eagletrt/an2can/README.md

# Analog to CAN converter

Standalone system capable of performing analog-to-digital conversion and preprocessing and output data over CAN BUS

## Contributors
Latest to oldest:
- Thomas Nonis
