eagletrt/an2can/an2can.kicad_pcb

## KiCad design an2can.kicad_pcb (2023-05-17)

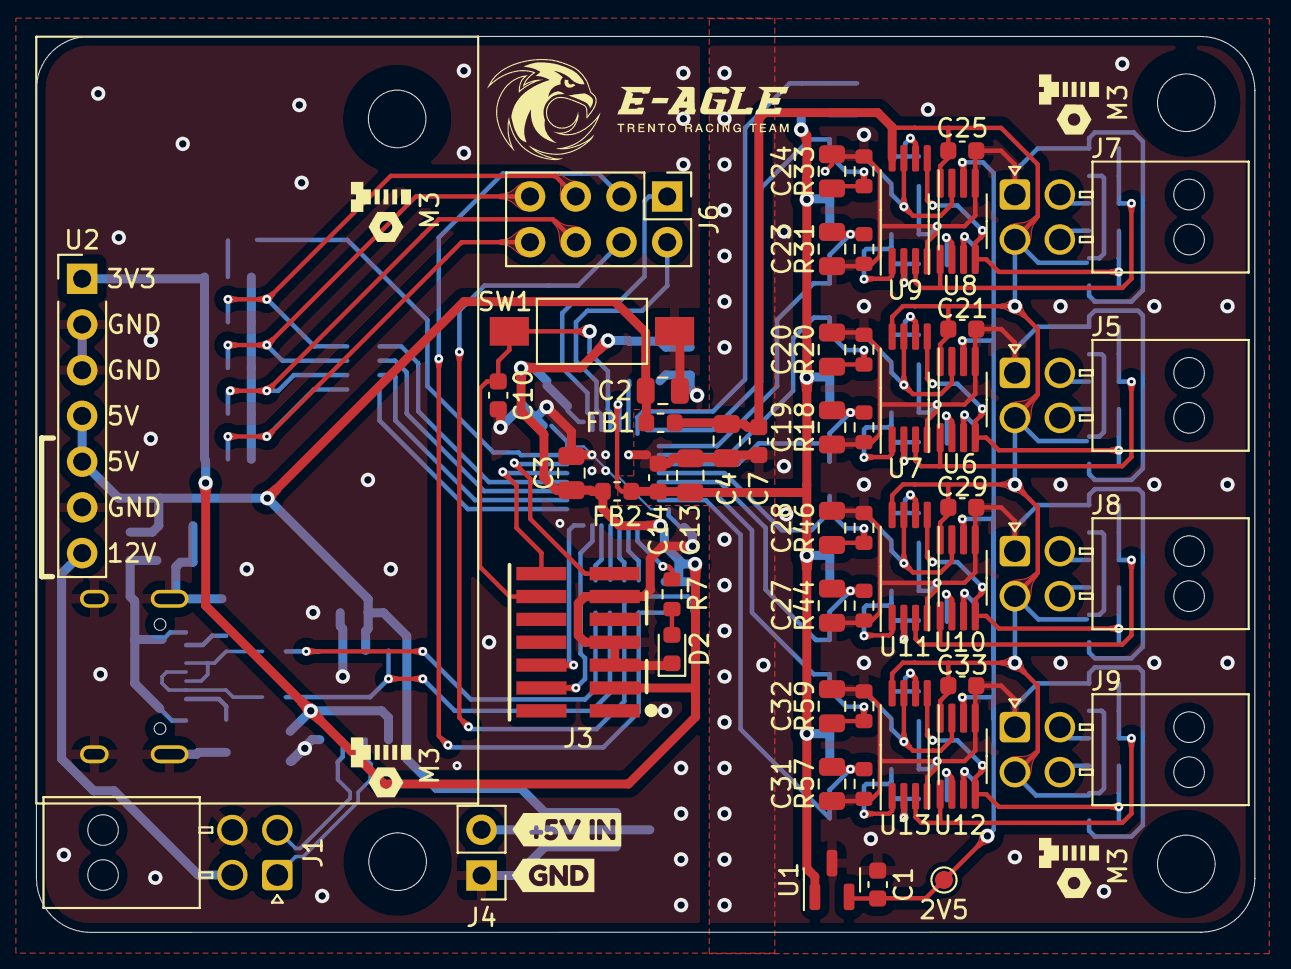
[picture p1: board an2can.kicad_pcb from above]

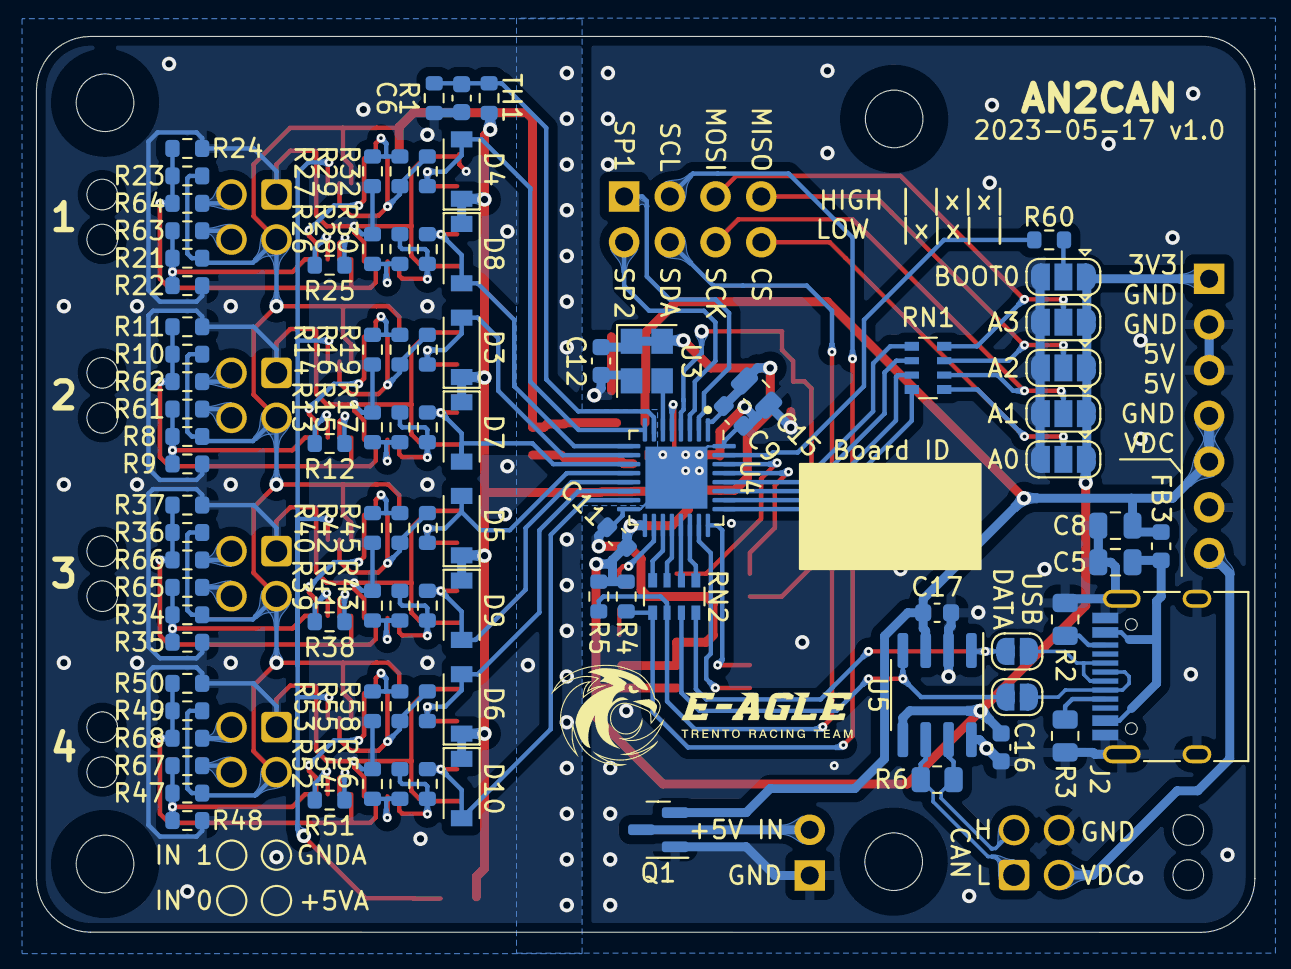
[picture p2: board an2can.kicad_pcb from below]

Board: 2 copper layers, 67.7 x 49.8 mm, 150 parts (92 on the bottom side), 93 nets.

Parts:
C1, C6, C9, C10, C11, C12, C14, C16, C17, C21, C25, C29, C33: 100n; C_0603_1608Metric
C2, C3, C4, C5, C8, C19, C20, C23, C24, C27, C28, C31, C32: C; C_0805_2012Metric
C7: C; C_0603_1608Metric
C13: 1u; C_0805_2012Metric
C15: 10u; C_0805_2012Metric
D2: USER LED; LED_0603_1608Metric
D3, D4, D5, D6, D7, D8, D9, D10: D_Schottky; D_SOD-123
FB1, FB2, FB3: FerriteBead; L_0603_1608Metric
H1, H2, H3: MountingHole; MountingHole_3.2mm_M3_ISO14580
J1: PWR/CAN; Molex_Nano-Fit_105314-xx04_2x02_P2.50mm_Horizontal
J2: USB C; USB_C_Receptacle_HRO_TYPE-C-31-M-12
J3: DBG; SAMTEC_FTSH-107-01-L-DV-K-TR
J4: 5V IN; PinHeader_1x02_P2.54mm_Vertical
J5, J7, J8, J9: Input; Molex_Nano-Fit_105314-xx04_2x02_P2.50mm_Horizontal
J6: Aux; PinHeader_2x04_P2.54mm_Vertical
JP1: A0; SolderJumper-3_P1.3mm_Open_RoundedPad1.0x1.5mm
JP2: A1; SolderJumper-3_P1.3mm_Open_RoundedPad1.0x1.5mm
JP3: A2; SolderJumper-3_P1.3mm_Open_RoundedPad1.0x1.5mm
JP4: A3; SolderJumper-3_P1.3mm_Open_RoundedPad1.0x1.5mm
JP5: BOOT0; SolderJumper-3_P1.3mm_Open_RoundedPad1.0x1.5mm
JP6: USB N; SolderJumper-2_P1.3mm_Open_RoundedPad1.0x1.5mm
JP7: USB P; SolderJumper-2_P1.3mm_Open_RoundedPad1.0x1.5mm
NT1: Net Tie; NetTie-2_SMD_Pad0.5mm
Q1: PMV65XP; SOT-23
R1, R4, R5, R13, R14, R15, R16, R17, R18, R19, R20, R26, R27, R28, R29, R30, R31, R32, R33, R39, R40, R41, R42, R43, R44, R45, R46, R52, R53, R54, R55, R56, R57, R58, R59, R60, R61, R62, R63, R64, R65, R66, R67, R68: R; R_0603_1608Metric
R2, R3: 5k1; R_0805_2012Metric
R6: 120; R_0805_2012Metric
R7: 1k; R_0603_1608Metric
R8, R9, R10, R11, R21, R22, R23, R24, R34, R35, R36, R37, R47, R48, R49, R50: 120 0.1%; R_0603_1608Metric
R12, R25, R38, R51: 220k 0.1%; R_0603_1608Metric
RN1, RN2: R; R_Array_Convex_4x0603
SW1: RESET; SW_SPST_FSMSM
TH1: Thermistor; R_0603_1608Metric
TP1: Offset; TestPoint_Pad_D1.0mm
U1: MAX6025; SOT-23
U2: Tex_DCDC_v2; Tex_DCDC_v2_horizontal
U3: DSC61XX; Crystal_SMD_3225-4Pin_3.2x2.5mm
U4: STM32L432KCUx; QFN-32-1EP_5x5mm_P0.5mm_EP3.45x3.45mm
U5: MCP2562FD; SOIC-8_3.9x4.9mm_P1.27mm
U6, U8, U10, U12: AD8221ARZ; MSOP-8_3x3mm_P0.65mm
U7, U9, U11, U13: Opamp_Dual; TSSOP-8_4.4x3mm_P0.65mm
kibuzzard-645FEBDB: G***; kibuzzard-645FEBDB
kibuzzard-645FEBF3: G***; kibuzzard-645FEBF3

Connections:
+3.3VA: C13.1, C14.1, D3.1 (K), D4.1 (K), D5.1 (K), D6.1 (K), D7.1 (K), D8.1 (K), D9.1 (K), D10.1 (K), FB2.2, TH1.1, U1.1 (IN), U4.5 (VDDA)
+3V3: C3.1, C9.1, C11.1, C12.1, C15.1, C16.1, FB2.1, J3.3 (VCC), JP1.1 (A), JP2.1 (A), JP3.1 (A), JP4.1 (A), JP5.1 (A), R4.1, R5.1, U2.1 (3V3), U3.1 (OE), U3.4 (VDD), U4.1 (VDD), U4.17 (VDD), U5.5 (Vio)
+5V: C2.1, C8.1, C17.1, FB1.1, FB3.2, Q1.2 (S), U2.4 (5V), U2.5 (5V), U5.3 (VDD)
+5VA: C4.1, C7.1, C21.2, C25.2, C29.2, C33.2, FB1.2, J5.2, J7.2, J8.2, J9.2, R8.1, R10.1, R21.1, R23.1, R34.1, R36.1, R47.1, R49.1, U6.8 (Vs+), U7.8 (V+), U8.8 (Vs+), U9.8 (V+), U10.8 (Vs+), U11.8 (V+), U12.8 (Vs+), U13.8 (V+)
/2V5_OFFSET: C1.2, TP1.1, U1.2 (OUT), U6.6 (Ref), U8.6 (Ref), U10.6 (Ref), U12.6 (Ref)
/A0: J6.8, JP1.2 (C), RN1.5 (R4.2)
/A1: J6.6, JP2.2 (C), RN1.6 (R3.2)
/A2: J6.7, JP3.2 (C), RN1.7 (R2.2)
/A3: J6.5, JP4.2 (C), RN1.8 (R1.2)
/CAN+: J1.2, R6.2, U5.7 (CANH)
/CAN-: J1.1, R6.1, U5.6 (CANL)
/Input Stage 1/IN_0: J7.4, R63.1
/Input Stage 1/IN_0+: R21.2, R22.1, R63.2, U8.4 (+), U9.5 (+)
/Input Stage 1/IN_0-: R27.1, R29.2, U9.6 (-)
/Input Stage 1/IN_1: J7.3, R64.2
/Input Stage 1/IN_1+: R23.2, R24.1, R64.1, U8.1 (-), U9.3 (+)
/Input Stage 1/IN_1-: R26.1, R28.2, U9.2 (-)
/Input Stage 1/OUT_COM: C24.1, D4.2 (A), R32.2, R33.1, U4.8 (PA2)
/Input Stage 1/OUT_COM_UNFLT: R29.1, R32.1, U8.7, U9.7
/Input Stage 1/OUT_SINGLE: C23.1, D8.2 (A), R30.1, R31.1, U4.9 (PA3)
/Input Stage 1/OUT_SINGLE_UNFLT: R28.1, R30.2, U9.1
/Input Stage 1/RG1: R25.1, U8.2 (Rg)
/Input Stage 1/RG2: R25.2, U8.3 (Rg)
/Input Stage 2/IN_0: J5.4, R61.1
/Input Stage 2/IN_0+: R8.2, R9.1, R61.2, U6.4 (+), U7.5 (+)
/Input Stage 2/IN_0-: R14.1, R16.2, U7.6 (-)
/Input Stage 2/IN_1: J5.3, R62.2
/Input Stage 2/IN_1+: R10.2, R11.1, R62.1, U6.1 (-), U7.3 (+)
/Input Stage 2/IN_1-: R13.1, R15.2, U7.2 (-)
/Input Stage 2/OUT_COM: C20.1, D3.2 (A), R19.2, R20.1, U4.10 (PA4)
/Input Stage 2/OUT_COM_UNFLT: R16.1, R19.1, U6.7, U7.7
/Input Stage 2/OUT_SINGLE: C19.1, D7.2 (A), R17.1, R18.1, U4.11 (PA5)
/Input Stage 2/OUT_SINGLE_UNFLT: R15.1, R17.2, U7.1
/Input Stage 2/RG1: R12.1, U6.2 (Rg)
/Input Stage 2/RG2: R12.2, U6.3 (Rg)
/Input Stage 3/IN_0: J8.4, R65.1
/Input Stage 3/IN_0+: R34.2, R35.1, R65.2, U10.4 (+), U11.5 (+)
/Input Stage 3/IN_0-: R40.1, R42.2, U11.6 (-)
/Input Stage 3/IN_1: J8.3, R66.2
/Input Stage 3/IN_1+: R36.2, R37.1, R66.1, U10.1 (-), U11.3 (+)
/Input Stage 3/IN_1-: R39.1, R41.2, U11.2 (-)
/Input Stage 3/OUT_COM: C28.1, D5.2 (A), R45.2, R46.1, U4.12 (PA6)
/Input Stage 3/OUT_COM_UNFLT: R42.1, R45.1, U10.7, U11.7
/Input Stage 3/OUT_SINGLE: C27.1, D9.2 (A), R43.1, R44.1, U4.13 (PA7)
/Input Stage 3/OUT_SINGLE_UNFLT: R41.1, R43.2, U11.1
/Input Stage 3/RG1: R38.1, U10.2 (Rg)
/Input Stage 3/RG2: R38.2, U10.3 (Rg)
/Input Stage 4/IN_0: J9.4, R67.1
/Input Stage 4/IN_0+: R47.2, R48.1, R67.2, U12.4 (+), U13.5 (+)
/Input Stage 4/IN_0-: R53.1, R55.2, U13.6 (-)
/Input Stage 4/IN_1: J9.3, R68.2
/Input Stage 4/IN_1+: R49.2, R50.1, R68.1, U12.1 (-), U13.3 (+)
/Input Stage 4/IN_1-: R52.1, R54.2, U13.2 (-)
/Input Stage 4/OUT_COM: C32.1, D6.2 (A), R58.2, R59.1, U4.14 (PB0)
/Input Stage 4/OUT_COM_UNFLT: R55.1, R58.1, U12.7, U13.7
/Input Stage 4/OUT_SINGLE: C31.1, D10.2 (A), R56.1, R57.1, U4.15 (PB1)
/Input Stage 4/OUT_SINGLE_UNFLT: R54.1, R56.2, U13.1
/Input Stage 4/RG1: R51.1, U12.2 (Rg)
/Input Stage 4/RG2: R51.2, U12.3 (Rg)
/MCU/+5V_USB_UNFILTERED: C5.1, FB3.1, J2.A4 (VBUS), J2.A9 (VBUS), J2.B4 (VBUS), J2.B9 (VBUS)
/MCU/BOOT0: R60.2, U4.31 (PH3)
/MCU/CAN_RX: JP6.1 (A), RN2.3 (R3.1), U5.4 (RXD)
/MCU/CAN_TX: JP7.1 (A), RN2.4 (R4.1), U5.1 (TXD)
/MCU/CLK: U3.3 (OUT), U4.6 (PA0)
/MCU/DBG_RX: J3.13 (VCP_RX), U4.30 (PB7)
/MCU/DBG_TX: J3.14 (VCP_TX), U4.29 (PB6)
/MCU/I2C_SCL: J6.3, R4.2, RN2.1 (R1.1)
/MCU/I2C_SDA: J6.4, R5.2, RN2.2 (R2.1)
/MCU/SWCLK: J3.6 (JCLK/SWCLK), U4.24 (PA14)
/MCU/SWDIO: J3.4 (JTMS/SWDIO), U4.23 (PA13)
/MCU/Spare1: J6.1, U4.2 (PC14)
/MCU/Spare2: J6.2, U4.3 (PC15)
/MCU/USB_N: J2.A7 (D-), J2.B7 (D-), JP6.2 (B)
/MCU/USB_P: J2.A6 (D+), J2.B6 (D+), JP7.2 (B)
/MCU/USER_LED: R7.1, U4.18 (PA8)
/MCU/~RESET: C10.1, J3.12 (~RST), SW1.2, U4.4 (NRST)
/Temp: C6.2, R1.1, TH1.2, U4.7 (PA1)
GND: C2.2, C3.2, C5.2, C8.2, C9.2, C10.2, C11.2, C12.2, C15.2, C16.2, C17.2, D2.1 (K), J1.4, J2.A1 (GND), J2.A12 (GND), J2.B1 (GND), J2.B12 (GND), J2.S1 (SHIELD), J3.5 (GND), J3.7 (GND), J3.11 (GNDDetect), J4.1, JP1.3 (B), JP2.3 (B), JP3.3 (B), JP4.3 (B), JP5.3 (B), NT1.1, Q1.1 (G), R2.2, R3.2, SW1.1, U2.2 (GND), U2.3 (GND), U2.6 (GND), U3.2 (GND), U4.16 (VSS), U4.32 (VSS), U4.33 (VSS), U5.2 (VSS), U5.8 (STBY)
GNDA: C1.1, C4.2, C6.1, C7.2, C13.2, C14.2, C19.2, C20.2, C21.1, C23.2, C24.2, C25.1, C27.2, C28.2, C29.1, C31.2, C32.2, C33.1, J5.1, J7.1, J8.1, J9.1, NT1.2, R1.2, R9.2, R11.2, R13.2, R14.2, R18.2, R20.2, R22.2, R24.2, R26.2, R27.2, R31.2, R33.2, R35.2, R37.2, R39.2, R40.2, R44.2, R46.2, R48.2, R50.2, R52.2, R53.2, R57.2, R59.2, U1.3 (GND), U6.5 (Vs-), U7.4 (V-), U8.5 (Vs-), U9.4 (V-), U10.5 (Vs-), U11.4 (V-), U12.5 (Vs-), U13.4 (V-)
unnamed: D2.2 (A), R7.2
unnamed: J2.A5 (CC1), R3.1
unnamed: J2.B5 (CC2), R2.1
unnamed: J4.2, Q1.3 (D)
unnamed: JP5.2 (C), R60.1
unnamed: RN1.1 (R1.1), U4.28 (PB5)
unnamed: RN1.2 (R2.1), U4.27 (PB4)
unnamed: RN1.3 (R3.1), U4.26 (PB3)
unnamed: RN1.4 (R4.1), U4.25 (PA15)
unnamed: RN2.5 (R4.2), U4.22 (PA12)
unnamed: RN2.6 (R3.2), U4.21 (PA11)
unnamed: RN2.7 (R2.2), U4.20 (PA10)
unnamed: RN2.8 (R1.2), U4.19 (PA9)
VDC: J1.3, U2.7 (VIN)
