eagletrt/an2can/(commit log)

2023-04-22 chore: edit template for project
    [an2can.kicad_pcb, an2can.kicad_sch]
2023-04-22 sch: first draft of mcu configuration
    [an2can.kicad_sch, mcu.kicad_sch]
2023-04-23 sch: add opamps
    [an2can.kicad_sch, mcu.kicad_sch]
2023-04-23 sch: change to stm32l432k and change analog input topology
    [an2can.kicad_sch, ina.kicad_sch, mcu.kicad_sch, opamp.kicad_sch]
2023-04-25 sch: input stage sheets
    [an2can.kicad_sch, ina.kicad_sch, input-stage.kicad_sch, mcu.kicad_sch, opamp.kicad_sch]
2023-05-01 sch: add power delivery network and finalize schematic
    [an2can.kicad_sch, input-stage.kicad_sch, mcu.kicad_sch]
2023-05-01 pcb: draft digital section and partial analog
    [an2can.kicad_pcb]
2023-05-01 sch: change single input connector to 4 02x02
    [an2can.kicad_sch, input-stage.kicad_sch, mcu.kicad_sch]
2023-05-01 pcb: full draft of positioning
    [an2can.kicad_pcb]
2023-05-08 sch: delete old ina sheet
    [ina.kicad_sch]
2023-05-08 sch: add input series resistor to form divider and clamp to opamp output
    [an2can.kicad_sch, input-stage.kicad_sch]
2023-05-08 pcb: define routing of input stage
    [an2can.kicad_pcb]
2023-05-09 pcb: finalize routing of analog section
    [an2can.kicad_pcb, an2can.kicad_sch, input-stage.kicad_sch]
2023-05-11 pcb: continue routing of digital section
    [an2can.kicad_pcb, mcu.kicad_sch]
2023-05-13 pcb: complete routing, add silkscreen details, finalize board
    [an2can.kicad_pcb, an2can.kicad_sch, mcu.kicad_sch]
2023-05-17 pcb: change oscillator footprint, add board id pad and move board name on back silkscreen
    [an2can.kicad_pcb, an2can.kicad_sch, mcu.kicad_sch]
2023-05-17 pcb: add teardrops
    [an2can.kicad_pcb]
2023-05-25 prod: generate v1.0 gerbers
    [an2can-B_Cu.gbl, an2can-B_Mask.gbs, an2can-B_Paste.gbp, an2can-B_Silkscreen.gbo, an2can-Edge_Cuts.gm1, an2can-F_Cu.gtl, an2can-F_Mask.gts, an2can-F_Paste.gtp]
